maissaelafani/Interactive_Vote_Counter_Prototype/Core/Src/main.c

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
/* Includes ------------------------------------------------------------------*/
#include "main.h"

/* USER CODE BEGIN Includes */
#include <stdbool.h>
#include <stdlib.h>
#include <stdio.h>
#include "ssd1306_tests.h" // librairies
#include "ssd1306.h"       // écran
#include "draw.h"          // OLED

/* USER CODE END Includes */

I2C_HandleTypeDef hi2c1;

TIM_HandleTypeDef htim1;
TIM_HandleTypeDef htim2;

UART_HandleTypeDef huart2;

void SystemClock_Config(void);
static void MX_GPIO_Init(void);
static void MX_TIM2_Init(void);
static void MX_USART2_UART_Init(void);
static void MX_TIM1_Init(void);
static void MX_I2C1_Init(void);
/* USER CODE BEGIN 0 */
volatile uint32_t value = 0;       // initialisation de la valeur de la période
volatile uint32_t tab[2] = {0, 0}; // initialisation du tableau contenant les valeurs du temps acquises
                                   // en début et en fin de période
volatile bool first = true;        // initialisation de la variable permettant de savoir si on est au
                                   // début ou à la fin d'une période
volatile int cpt = 0;              // initialisation du compteur
volatile bool tim1_started = 0;    // initialisation de la variable permettant de savoir si le Timer 1
                                   // est démarré
volatile bool button_state = false;
volatile bool current_state = false;
volatile bool led_state = false;
volatile uint32_t frequency = 0;
char str[20];

/* USER CODE END 0 */

/**
  * @brief  The application entry point.
  * @retval int
  */
int main(void)
{
  /* MCU Configuration--------------------------------------------------------*/

  /* Reset of all peripherals, Initializes the Flash interface and the Systick. */
  HAL_Init();

  /* Configure the system clock */
  SystemClock_Config();

  /* Initialize all configured peripherals */
  MX_GPIO_Init();
  MX_TIM2_Init();
  MX_USART2_UART_Init();
  MX_TIM1_Init();
  MX_I2C1_Init();
  /* USER CODE BEGIN 2 */


  while(button_state == false)
  {
      if (HAL_GPIO_ReadPin(GPIOA, GPIO_PIN_4) == GPIO_PIN_RESET) {
    	  	  button_state = true;
          }
      }
  button_state = false;
  ssd1306_DrawLogo(); // Affichage démarrage du compteur


  /* USER CODE END 2 */

  /* Infinite loop */
  /* USER CODE BEGIN WHILE */

  while (1)
  {
    /* USER CODE END WHILE */

    /* USER CODE BEGIN 3 */

	  /*HAL_GPIO_WritePin(GPIOB, LD3_Pin , 1); //test entrée dans la boucle while
	  HAL_Delay(500);
	  HAL_GPIO_WritePin(GPIOB, LD3_Pin , 0);
	  HAL_Delay(500);*/
	  while(button_state == false)
	    {
		  HAL_TIM_IC_Start_IT(&htim2, TIM_CHANNEL_1);
		  	  sprintf(str, "%d", cpt); //affichage du compteur permanent
		  	  ssd1306_SetCursor(50, 25);
		  	  ssd1306_WriteString(str, Font_16x26, White);
		  	  ssd1306_UpdateScreen();

	            // Si le bouton est enfoncé, exécuter le reste du programme
	        if (HAL_GPIO_ReadPin(GPIOA, GPIO_PIN_4) == GPIO_PIN_RESET) {
	      	  	  button_state = true;
	            }
	        }
	  button_state = false;
	  cpt = 0;
	  ssd1306_Init();


  }




  /* USER CODE END 3 */
}

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
/* USER CODE BEGIN 4 */
void HAL_TIM_IC_CaptureCallback(TIM_HandleTypeDef* htim2)
{

	if (htim2->Instance == TIM2)
	{

		if (first == 1)
		{
			tab[0] = HAL_TIM_ReadCapturedValue(htim2, TIM_CHANNEL_1);
			first = 0;
		}
		else
		{
			tab[1] = HAL_TIM_ReadCapturedValue(htim2, TIM_CHANNEL_1);
			value = tab[1] - tab[0];
			frequency = HAL_RCC_GetPCLK1Freq()/value;
			first = 1;
			HAL_TIM_IC_Stop_IT(htim2, TIM_CHANNEL_1);
		}
		if (value>1100)
		{
			if (tim1_started == 0)
			{
				__HAL_TIM_SET_COUNTER(&htim1, 0);
				HAL_TIM_Base_Start_IT(&htim1);
				tim1_started = 1;
			}
		}
		else if (value<1100)
		{
			HAL_TIM_Base_Stop_IT(&htim1);
			tim1_started = 0;
		}
	}
}


void HAL_TIM_PeriodElapsedCallback(TIM_HandleTypeDef *htim)
{
  if (htim->Instance == TIM1)
  {
	  HAL_GPIO_WritePin(GPIOB, LD3_Pin , led_state);
	  led_state = (led_state == 0) ? 1 : 0;
		  cpt++;

  }
}

bool read_button() { // Lire l'état de la broche du bouton poussoir
    GPIO_PinState button_state = HAL_GPIO_ReadPin(GPIOA, GPIO_PIN_4);

    // Convertir l'état de la broche en un booléen (true pour enfoncé, false pour relâché)
    if (button_state == GPIO_PIN_SET) {
        return true; // Bouton enfoncé
    } else {
        return false; // Bouton relâché
    }
}


/* USER CODE END 4 */
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
