maissaelafani/Interactive_Vote_Counter_Prototype/prototypage.ioc

Mcu.UserName=STM32F301K8Tx
PA0.Signal=S_TIM2_CH1_ETR
PA2.Signal=USART2_TX
PA3.Signal=USART2_RX
PA4.Signal=GPIO_Input
PA8.Signal=RCC_MCO
PB3.GPIO_Label=LD3
PB3.Signal=GPIO_Output
PB6.Signal=I2C1_SCL
PB7.Signal=I2C1_SDA
PF0-OSC_IN.Signal=RCC_OSC_IN
PF1-OSC_OUT.Signal=RCC_OSC_OUT
