maissaelafani/Interactive_Vote_Counter_Prototype/Core/Src/draw.c

#include <string.h>
#include <stdio.h>
#include "ssd1306.h"
#include "ssd1306_tests.h"


const unsigned char logo_vote [] = {
	// 'vote4, 64x64px
	0x00, 0x00, 0x00, 0x00, 0x00, 0x00, 0x00, 0x00, 0x00, 0x00, 0x00, 0x00, 0x00, 0x00, 0x00, 0x00,
	0x00, 0x00, 0x00, 0x00, 0x00, 0x00, 0x00, 0x00, 0x00, 0x00, 0x00, 0x00, 0x00, 0x00, 0x00, 0x00,
	0x00, 0x00, 0x00, 0x00, 0x00, 0x00, 0x00, 0x00, 0x00, 0x00, 0x00, 0x00, 0x00, 0x00, 0x00, 0x00,
	0x00, 0x00, 0x00, 0x00, 0x00, 0x00, 0x00, 0x00, 0x00, 0x00, 0x00, 0x00, 0x00, 0x00, 0x00, 0x00,
	0x00, 0x00, 0x00, 0x00, 0x00, 0x00, 0x60, 0x00, 0x00, 0x00, 0x00, 0x00, 0x00, 0x01, 0xb0, 0x00,
	0x00, 0x00, 0x00, 0x00, 0x07, 0xfb, 0x10, 0x00, 0x00, 0x00, 0x00, 0x03, 0x88, 0x0f, 0x18, 0x00,
	0x00, 0x00, 0x00, 0x02, 0xf8, 0x01, 0x08, 0x00, 0x00, 0x00, 0x00, 0x04, 0x0f, 0x00, 0x88, 0x00,
	0x00, 0x00, 0x00, 0x04, 0x01, 0xc0, 0x84, 0x00, 0x00, 0x00, 0x00, 0x04, 0x00, 0xc0, 0xc4, 0x00,
	0x00, 0x00, 0x00, 0x0c, 0x03, 0x80, 0x42, 0x00, 0x00, 0x00, 0x00, 0x08, 0x1e, 0x00, 0x46, 0x00,
	0x00, 0x00, 0x00, 0x08, 0x20, 0x00, 0x7c, 0x00, 0x00, 0x00, 0x00, 0x18, 0x20, 0x43, 0xb0, 0x00,
	0x00, 0x00, 0x00, 0x10, 0x1f, 0xfe, 0x00, 0x00, 0x00, 0x00, 0x00, 0x10, 0x01, 0x00, 0x00, 0x00,
	0x00, 0x00, 0x00, 0x10, 0x02, 0x00, 0x00, 0x00, 0x00, 0x00, 0x00, 0x20, 0x02, 0x00, 0x00, 0x00,
	0x00, 0x00, 0x7f, 0xe0, 0x03, 0xfc, 0x00, 0x00, 0x00, 0x00, 0x40, 0x20, 0x06, 0x02, 0x00, 0x00,
	0x00, 0x00, 0x80, 0x60, 0x04, 0x03, 0x00, 0x00, 0x00, 0x01, 0x83, 0xff, 0xff, 0x81, 0x00, 0x00,
	0x00, 0x01, 0x00, 0x00, 0x00, 0x00, 0x80, 0x00, 0x00, 0x03, 0x00, 0x00, 0x00, 0x00, 0x80, 0x00,
	0x00, 0x03, 0xff, 0xff, 0xff, 0xff, 0xc0, 0x00, 0x00, 0x02, 0x00, 0x00, 0x00, 0x00, 0x40, 0x00,
	0x00, 0x02, 0x00, 0x00, 0x00, 0x00, 0x40, 0x00, 0x00, 0x02, 0x00, 0x00, 0x00, 0x00, 0x40, 0x00,
	0x00, 0x03, 0xff, 0xff, 0xff, 0xff, 0xc0, 0x00, 0x00, 0x01, 0x00, 0x00, 0x00, 0x01, 0x80, 0x00,
	0x00, 0x01, 0x00, 0x00, 0x00, 0x00, 0x80, 0x00, 0x00, 0x01, 0x00, 0x00, 0x00, 0x01, 0x80, 0x00,
	0x00, 0x01, 0x00, 0x00, 0x00, 0x01, 0x80, 0x00, 0x00, 0x01, 0x00, 0x00, 0x00, 0x01, 0x80, 0x00,
	0x00, 0x01, 0x00, 0x04, 0x40, 0x01, 0x80, 0x00, 0x00, 0x01, 0x02, 0x2b, 0x7b, 0x41, 0x80, 0x00,
	0x00, 0x01, 0x02, 0x51, 0x32, 0x01, 0x80, 0x00, 0x00, 0x01, 0x01, 0x51, 0x33, 0x80, 0x80, 0x00,
	0x00, 0x01, 0x01, 0x91, 0x32, 0x01, 0x80, 0x00, 0x00, 0x01, 0x01, 0x99, 0x32, 0x01, 0x80, 0x00,
	0x00, 0x01, 0x00, 0x8e, 0x13, 0xc1, 0x80, 0x00, 0x00, 0x01, 0x00, 0x00, 0x00, 0x01, 0x80, 0x00,
	0x00, 0x01, 0x00, 0x00, 0x00, 0x01, 0x80, 0x00, 0x00, 0x01, 0x00, 0x00, 0x00, 0x00, 0x80, 0x00,
	0x00, 0x01, 0x00, 0x00, 0x00, 0x01, 0x80, 0x00, 0x00, 0x01, 0x00, 0x00, 0x00, 0x00, 0x80, 0x00,
	0x00, 0x01, 0x00, 0x00, 0x00, 0x01, 0x80, 0x00, 0x00, 0x01, 0xff, 0xff, 0xff, 0xff, 0x00, 0x00,
	0x00, 0x00, 0x00, 0x00, 0x00, 0x00, 0x00, 0x00, 0x00, 0x00, 0x00, 0x00, 0x00, 0x00, 0x00, 0x00,
	0x00, 0x00, 0x00, 0x00, 0x00, 0x00, 0x00, 0x00, 0x00, 0x00, 0x00, 0x00, 0x00, 0x00, 0x00, 0x00,
	0x00, 0x00, 0x00, 0x00, 0x00, 0x00, 0x00, 0x00, 0x00, 0x00, 0x00, 0x00, 0x00, 0x00, 0x00, 0x00,
	0x00, 0x00, 0x00, 0x00, 0x00, 0x00, 0x00, 0x00, 0x00, 0x00, 0x00, 0x00, 0x00, 0x00, 0x00, 0x00,
	0x00, 0x00, 0x00, 0x00, 0x00, 0x00, 0x00, 0x00, 0x00, 0x00, 0x00, 0x00, 0x00, 0x00, 0x00, 0x00
};

void ssd1306_DrawLogo()
{
	ssd1306_Init();
    ssd1306_Fill(Black);
    ssd1306_SetCursor(0, 0);
    ssd1306_WriteString(".....DEMARRAGE.....", Font_7x10, White);
    ssd1306_DrawBitmap(32,16,logo_vote,64,64,White);
    ssd1306_UpdateScreen();
    HAL_Delay(4000);
    ssd1306_Fill(Black);
    ssd1306_UpdateScreen();
}
