maissaelafani/Interactive_Vote_Counter_Prototype/Core/Inc/draw.h

/*
 * draw.h
 *
 *  Created on: Mar 20, 2024
 *      Author: maiss
 */

#ifndef INC_DRAW_H_
#define INC_DRAW_H_

#include <_ansi.h>

_BEGIN_STD_C

void ssd1306_DrawLogo();
void ssd1306_DrawLogoBis();

_END_STD_C


#endif /* INC_DRAW_H_ */
