maissaelafani/Interactive_Vote_Counter_Prototype/(commit log)

2024-04-12 Create drivers
2024-04-12 Create device
2024-04-12 Create stm32
